RalphWystup/Segway-Regelung-mit-ESP32-und-Schrittmotoren/modell/bericht_entwurf.txt

==============================================================================
NACHWEIS DES ENTWURFS AM VOLLSTAENDIGEN MODELL
==============================================================================

Aufbau     m = 0.35 kg, l = 0.120 m, J = 0.00672 kg m2
           Rad 66.0 mm, 1600 Schritte je Umdrehung -> 0.1296 mm je Schritt
           Kippzeitkonstante 0.1277 s
           Rampe 6.48 m/s2, Totzone 0 Hz, Grenze 6000 Hz

Regler     K  = 2.325 m/s je rad   Tn = 0.0866 s   Tv = 0.0088 s
           ki = K/Tn = 26.84  (Bedingung ki > g = 9,81 erfuellt)
Nullpunkt  K  = 0.0813 rad je m/s   Tn = 2.272 s   Grenze 6.0 Grad
Filter     Q_ANGLE = 0.0010  Q_BIAS = 0.0030  R_MEASURE = 309.30
           Beschleunigungskompensation: aus

------------------------------------------------------------------------------
A  GRENZEN
------------------------------------------------------------------------------
   Fangbereich aus der Ruhe           20.5 Grad
   Sicherheitsabschaltung             30.0 Grad
   Stossfestigkeit (50 ms)           0.420 Nm
   Nullpunkttoleranz                   8.5 mm Schwerpunktversatz
   groesste geforderte Beschleunigung  6.48 m/s2 (zulaessig 6.48)
   groesste Schrittfrequenz           2083 Hz (Grenze 6000)

   Fangfeld (ja = richtet auf), Winkel senkrecht, Drehrate waagerecht
               0      30      60      90     120     180  Grad/s
     0        ja      ja      ja      ja      ja    nein
     2        ja      ja      ja      ja      ja    nein
     5        ja      ja      ja      ja      ja    nein
     8        ja      ja      ja      ja    nein    nein
    10        ja      ja      ja      ja    nein    nein
    15        ja      ja    nein    nein    nein    nein
    20        ja    nein    nein    nein    nein    nein

------------------------------------------------------------------------------
B  ISTWINKEL NULL BEDEUTET STILLSTAND
------------------------------------------------------------------------------
   Weg in den letzten 20 s             0.0016 m
   mittlerer Istwinkel                0.00004 Grad
   Streuung des Istwinkels            0.00181 Grad
   mittlere Geschwindigkeit           0.00008 m/s
   gefundener Nullpunkt               -0.0108 Grad

------------------------------------------------------------------------------
C  SCHICHT 4 FINDET DEN GLEICHGEWICHTSWINKEL
------------------------------------------------------------------------------
   Versatz   berechnet    gefunden    Weg
    0.5 mm   -0.2387 Grad  -0.2496 Grad   0.117 m  stabil
    1.0 mm   -0.4775 Grad  -0.4883 Grad   0.234 m  stabil
    2.0 mm   -0.9548 Grad  -0.9657 Grad   0.467 m  stabil
    4.0 mm   -1.9092 Grad  -1.9200 Grad   0.933 m  stabil

------------------------------------------------------------------------------
D  MIT UND OHNE SCHICHT 4
------------------------------------------------------------------------------
   Versatz   ohne Korrektur          mit Korrektur
   0.05 mm  FAELLT   Weg   2.42 m   stabil   Weg   0.01 m
   0.10 mm  FAELLT   Weg   2.69 m   stabil   Weg   0.02 m
   0.20 mm  FAELLT   Weg   3.27 m   stabil   Weg   0.05 m
   0.50 mm  FAELLT   Weg   2.03 m   stabil   Weg   0.12 m
   1.00 mm  FAELLT   Weg   1.47 m   stabil   Weg   0.23 m
   2.00 mm  FAELLT   Weg   1.06 m   stabil   Weg   0.47 m
   5.00 mm  FAELLT   Weg   0.66 m   stabil   Weg   1.16 m

------------------------------------------------------------------------------
E  FAHRBEFEHL
------------------------------------------------------------------------------
   befohlen 0.065 m/s -> erreicht 0.066 m/s bei 0.001 Grad Neigung
   befohlen 0.130 m/s -> erreicht 0.131 m/s bei 0.002 Grad Neigung
   befohlen 0.259 m/s -> erreicht 0.260 m/s bei 0.003 Grad Neigung
   befohlen 0.389 m/s -> erreicht 0.390 m/s bei 0.005 Grad Neigung

==============================================================================
Bilder geschrieben: entwurf1 bis entwurf3
