RalphWystup/Segway-Regelung-mit-ESP32-und-Schrittmotoren/PRUEFPROTOKOLL_Einfuehrung.pdf

# Prüfprotokoll — Einführungsdokument zum Segway

### Prof. Dr.-Ing. Ralph Wystup M.Sc. — erstellt mit KI und Agent (Claude Code, Anthropic)

### 29. September 2026 · zu Fassung 6 des Manuskripts · Prüfmittel

Einfuehrung/pruefe_einfuehrung.py · 0 Beanstandung(en) bei 13 Prüfungen

## Aufgabe

Das Einführungsdokument zeigt die exakte Struktur von Strecke, abgetastetem System, Simulation, Firmware-Peripherie, Hardware und Hardwaretest mit Seitenverweisen ins Manuskript. Vorgabe: Software und Simulation müssen dem Bild entsprechen, ohne Abweichung. Jede Zeile hat eine Schranke.

Nr. | Prüfung | Schranke | Istwert | Ergebnis
E1 | 26 Seitenverweise zeigen auf die Seite mit der Überschrift | alle | fehlen: keine | ok
E1b | jede im Dokument genannte Seite liegt im Manuskript | 1 … 9463 | 11–57 | ok
E2 | 31 Bezeichner in den Tabellen: jeder steht in der Firmware oder im Labor-Modell | alle | fehlen: keine | ok
E3 | Modell-Bezeichner und Klassen im
Python-Modell und im Labor-Modell

alle in
beiden
| fehlen py: keine; js: keine | ok
E3b | die vier Schichten als Klassen in der
Firmware (Schicht 3 heißt dort Motoreinheit)
alle | fehlen: keine | ok
E4 | Werte der Tabellen = Werte im
Quelltext der Firmware (K, T_n, T_v, K_N, T_n,N, Rad, N_s, Q)
identisch | Abweichungen: keine | ok
E4b | Takt T der Firmware = Takt des
Modells
gleich | 0.004 s gegen 0.004 s | ok
E5 | Strukturbilder ohne Zahlenwerte von
Parametern (nur Variablen und Seitenverweise)
0 Funde | keine | ok
E6 | Schichten 1–4 in derselben
Reihenfolge definiert (Firmware,
Python, Labor)
ja | True, True, True | ok
E6b | Takt in den Bildern nur als T; Firmware TAKT_MS, Labor f_gitter | vorhanden | TAKT_MS True, f_gitter True

ok

E7 | 7 Bilder vorhanden, ≥ 700 px, ≤ 2,4 : 1 | alle | fehlen keine; klein keine; breit keine

ok

E8 | PDF gesetzt; Bilderfolge 1–7 vollständig; Fassung und Datum des Manuskripts im Kopf
alle | fehlen: keine; Kopf: True | ok
E9 | Abschnitt „Der Hardwaretest …“ und
Bild des Ablaufs im Manuskript
beides | True, True | ok

1

## Ergebnis

13 Prüfungen, 0 Beanstandung(en).

2
