RalphWystup/Segway-Regelung-mit-ESP32-und-Schrittmotoren/bilder/entwurf1_aufrichten.png

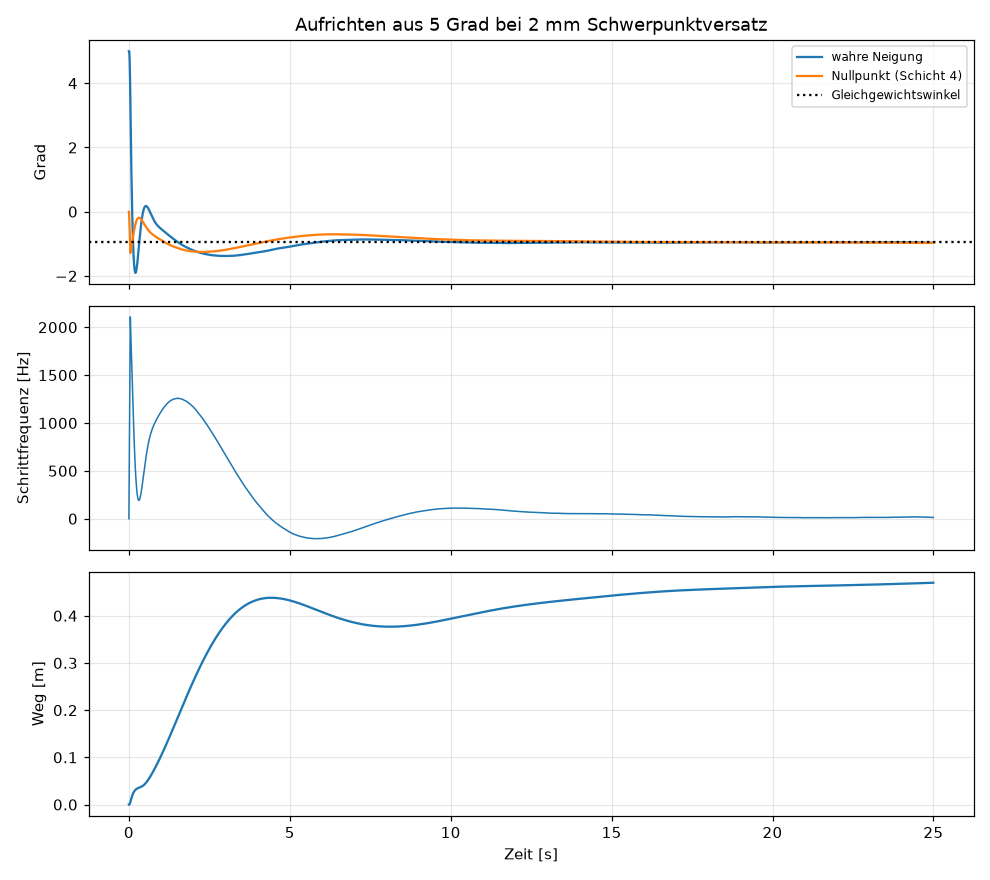
bilder/entwurf1_aufrichten.png
