RalphWystup/Segway-Regelung-mit-ESP32-und-Schrittmotoren/bilder/strecke_skizze.png

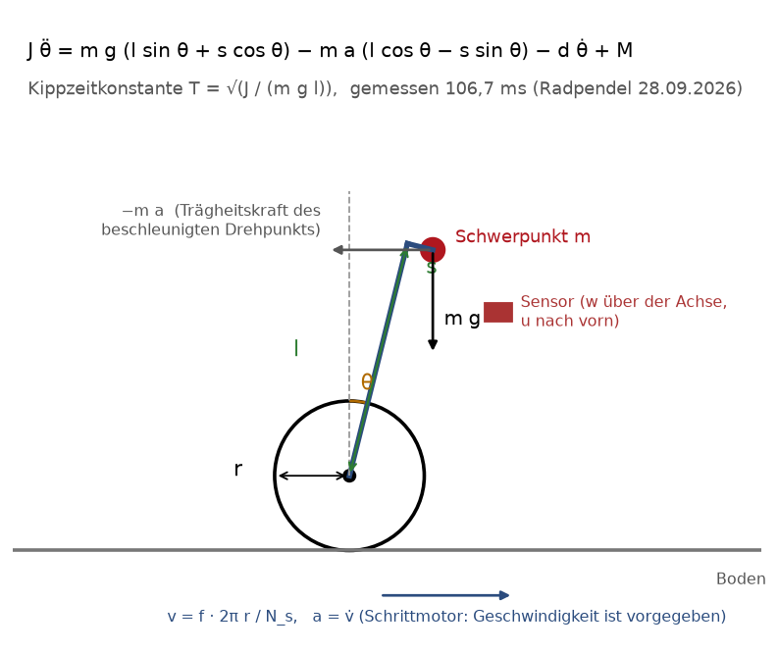
bilder/strecke_skizze.png
