RalphWystup/Segway-Regelung-mit-ESP32-und-Schrittmotoren/(commit log)

2026-09-29 Segway-Regelung mit ESP32 und Schrittmotoren (Fassung 6, Labor 1.2)
    Manuskript Fassung 6 mit Zustandsmodell, Uebertragungsfunktion, Laplace- und
    z-Bereich und Pruefprotokoll; Einfuehrungsdokument mit den Strukturbildern und
    dem Hardwaretest; Laborseite 1.2 mit laufender Wiedergabe und bewegtem Modell;
    Modell, Firmware, Konstruktion, Pruefstand, Massblatt, Video.
2026-09-30 Angaben fuer Zenodo
    Titel, Beschreibung, Schlagwoerter, Lizenz und Verweise, damit beim Archivieren
    nichts von Hand eingetippt werden muss.
2026-09-30 Kopfangaben fuer Suchmaschinen
    Kurzbeschreibung, kanonische Adresse, Vorschauangaben fuer geteilte Links und
    Strukturdaten nach schema.org — in der Seite und in der Weiterleitung. Die
    Angaben stammen aus derselben Quelle wie Startseite und Sitemap.
2026-09-30 Zitierangabe
    CITATION.cff: GitHub zeigt damit den Knopf "Cite this repository" mit fertigem
    Zitat, und Literaturverwaltungen koennen die Angabe auslesen. Ohne DOI und ohne
    Dritte.
